Manuel3409/BauhallenUhr/Bilder/CABLE-PH04_sml.webp

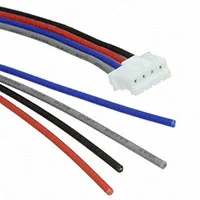
Bilder/CABLE-PH04_sml.webp
