Manuel3409/BauhallenUhr/README.md

# BauhallenUhr
Rework of the original BauhallenUhr - Projekt.
