Manuel3409/BauhallenUhr/Datenblaetter/Cable_Connector_XT60H_F.md

Cable\_Connector\_XT60H\_F

Link: [https://www.tme.eu/de/details/xt60h-f/dc-steckverbinder/amass/](https://www.tme.eu/de/details/xt60h-f/dc-steckverbinder/amass/)
