Manuel3409/BauhallenUhr/Datenblaetter/PCB_Connector_XT60PW_M.md

PCB\_Connector\_XT60PW\_M

Link: [https://www.tme.eu/de/details/xt60pw-m/dc-steckverbinder/amass/](https://www.tme.eu/de/details/xt60pw-m/dc-steckverbinder/amass/)
