Manuel3409/BauhallenUhr/00_Vorlagen_IPA/Vorlage_Bildformatierung.docx

Mit Textfeld:


Abbildung 1: ESP32S3 Devkit C1, Espressif

Abbildung 1: Unsichtbares Textfeld, darin befindet sich Bild und Bildbeschriftung.

Textfeld fixiert auf Seite, Textumbruch «oben und unten».

Abbildungsverzeichnis
