Manuel3409/BauhallenUhr/Bilder/300px-ST3025_Servo.jpg

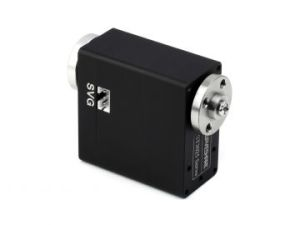
Bilder/300px-ST3025_Servo.jpg
