Manuel3409/BauhallenUhr/Blackbox_BauhallenUhr_V0.1.png

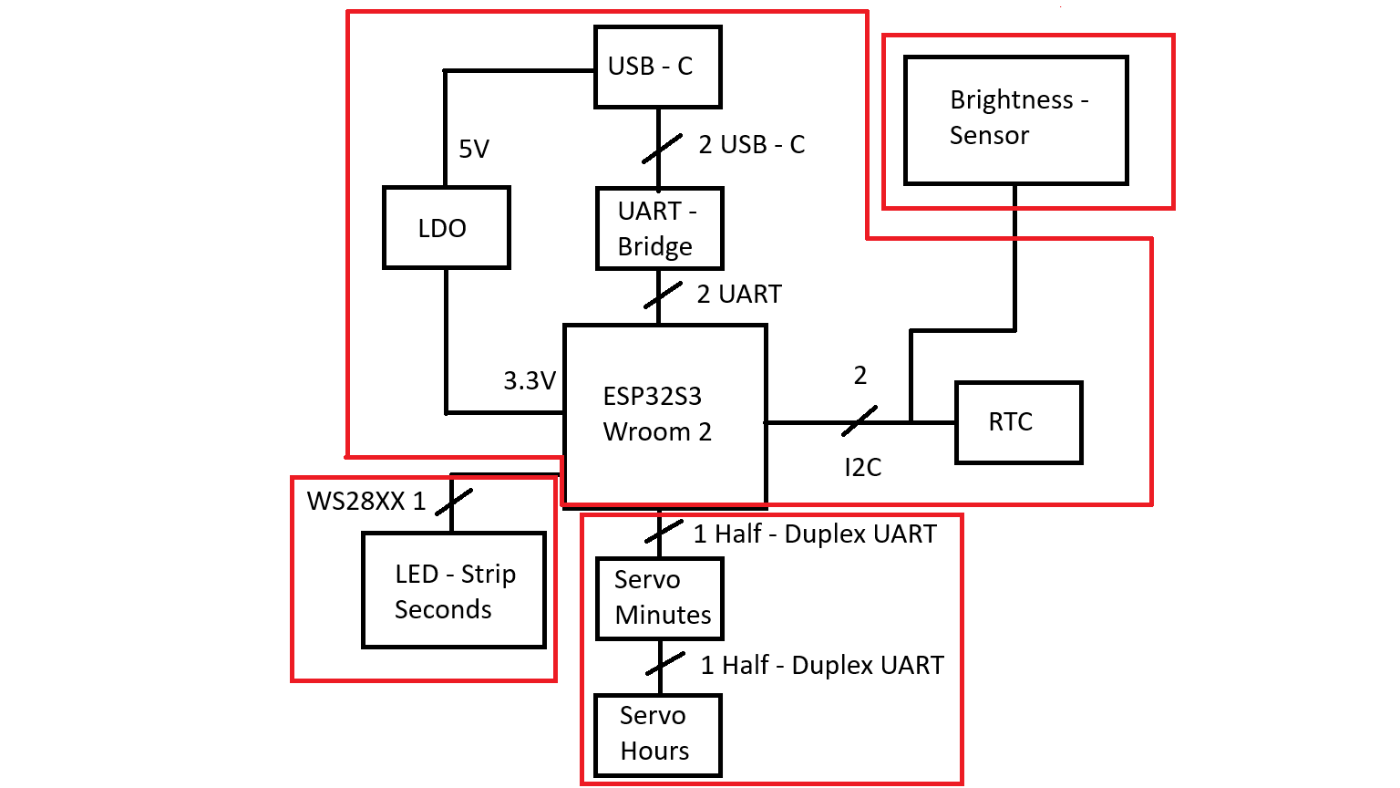
Blackbox_BauhallenUhr_V0.1.png
