Manuel3409/BauhallenUhr/00_Vorlagen_IPA/Stückliste_Vorlage.xlsx

Bestellliste IBK DBAUG
Anzahl PCBs |  | 1
 | Bezeichnung | Name | Wert | Anzahl pro Print | Anzahl gesamt | Zu bestellen | Stückpreis | Preis gesamt | Lieferant | Artikelnummer | Herstellernummer | Bestellstatus
1 |  |  |  |  | 0 |  |  | CHF 0.00
2 |  |  |  |  | 0 |  |  | CHF 0.00
3 |  |  |  |  | 0 |  |  | CHF 0.00
4 |  |  |  |  | 0 |  |  | CHF 0.00
 |  |  |  |  |  |  | Gesamtpreis | CHF 0.00
 | Nicht gefunden
 | Bestellt
 | Nicht bestellt
