Manuel3409/BauhallenUhr/Altium_BauhallenUhr_V2.0/3D_Modelle/SK68XXMINI-HS--3DModel-STEP-269445.STEP

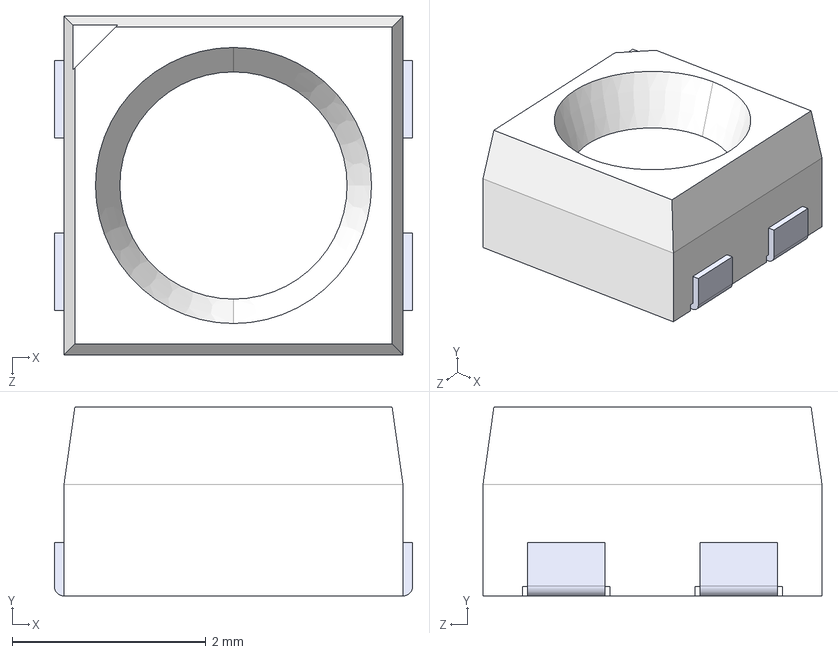
[picture p64: CAD file, 2026-10-23]
Altium_BauhallenUhr_V2.0/3D_Modelle/SK68XXMINI-HS--3DModel-STEP-269445.STEP
3.70 x 1.95 x 3.50 mm
