Manuel3409/BauhallenUhr/Altium_BauhallenUhr_V2.0/BauhallenUhr.pdf

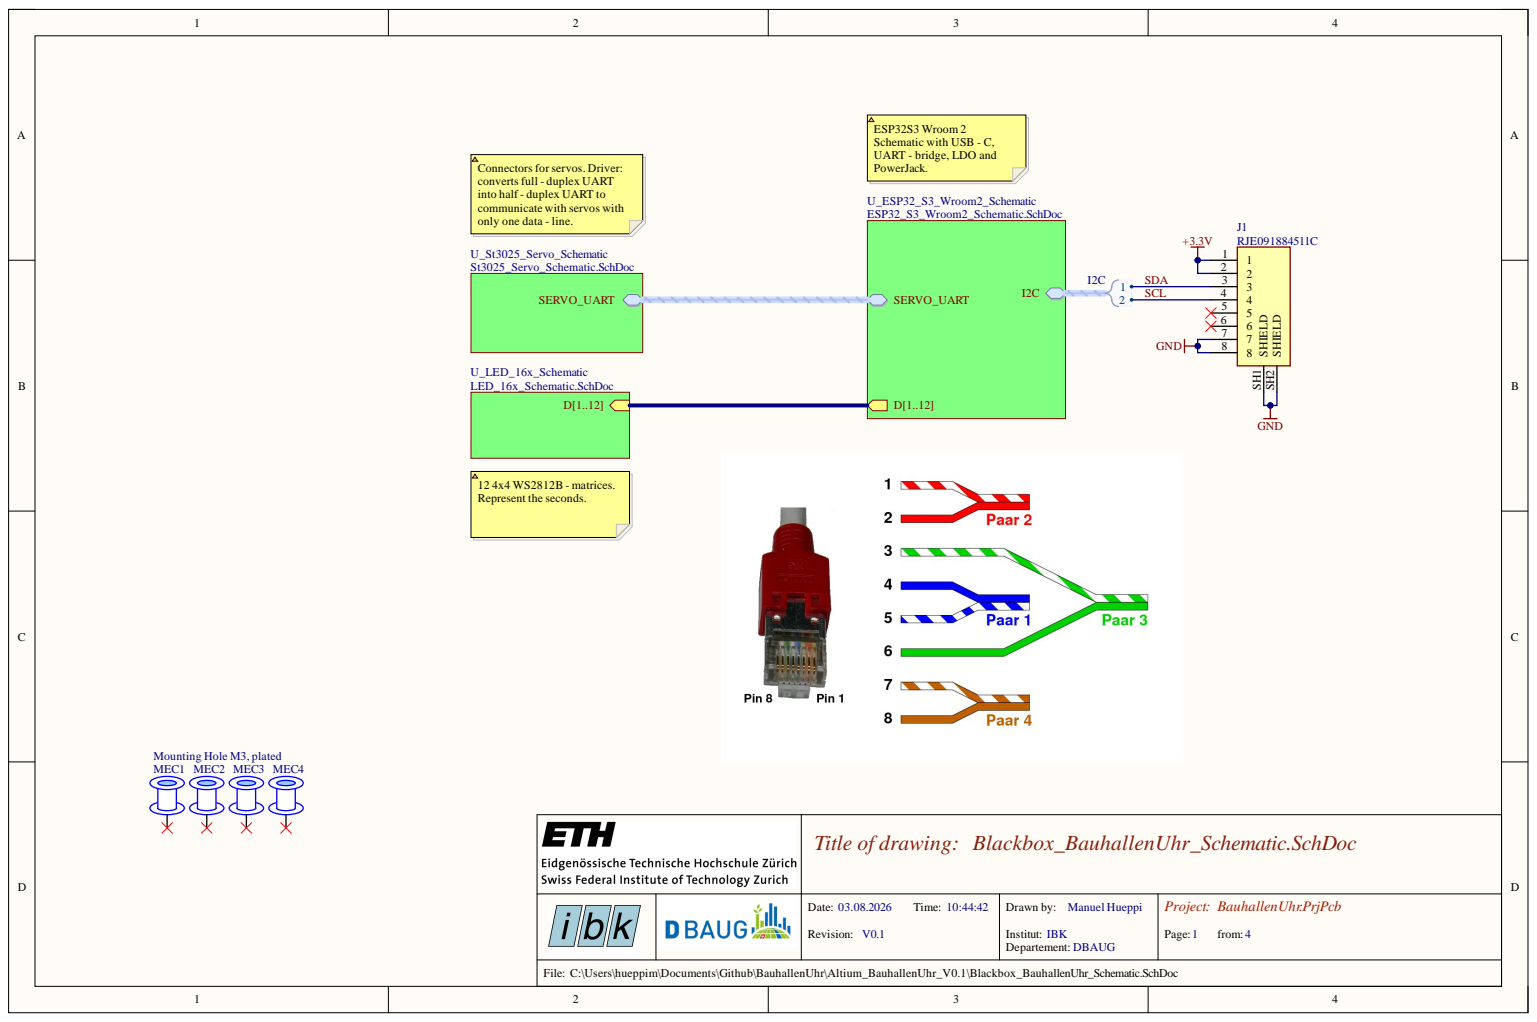
[picture p65: page 1]

Title of drawin g : Blackb ox_Ba u h allenUhr_ S c h e m a t i c . S c h D o c

Dat e : 0 3.0 8 . 2 0 2 6 T ime : 1 0 : 4 4 : 4 2 Rev i s i o n : V 0 . 1 | Draw n b y : Man uel H uep p i In s t i tu t : IBK Departemen t : DBA U G | Proje c t: Ba u h alle nUh r. P rjP c b Pag e : 1 fro m : 4

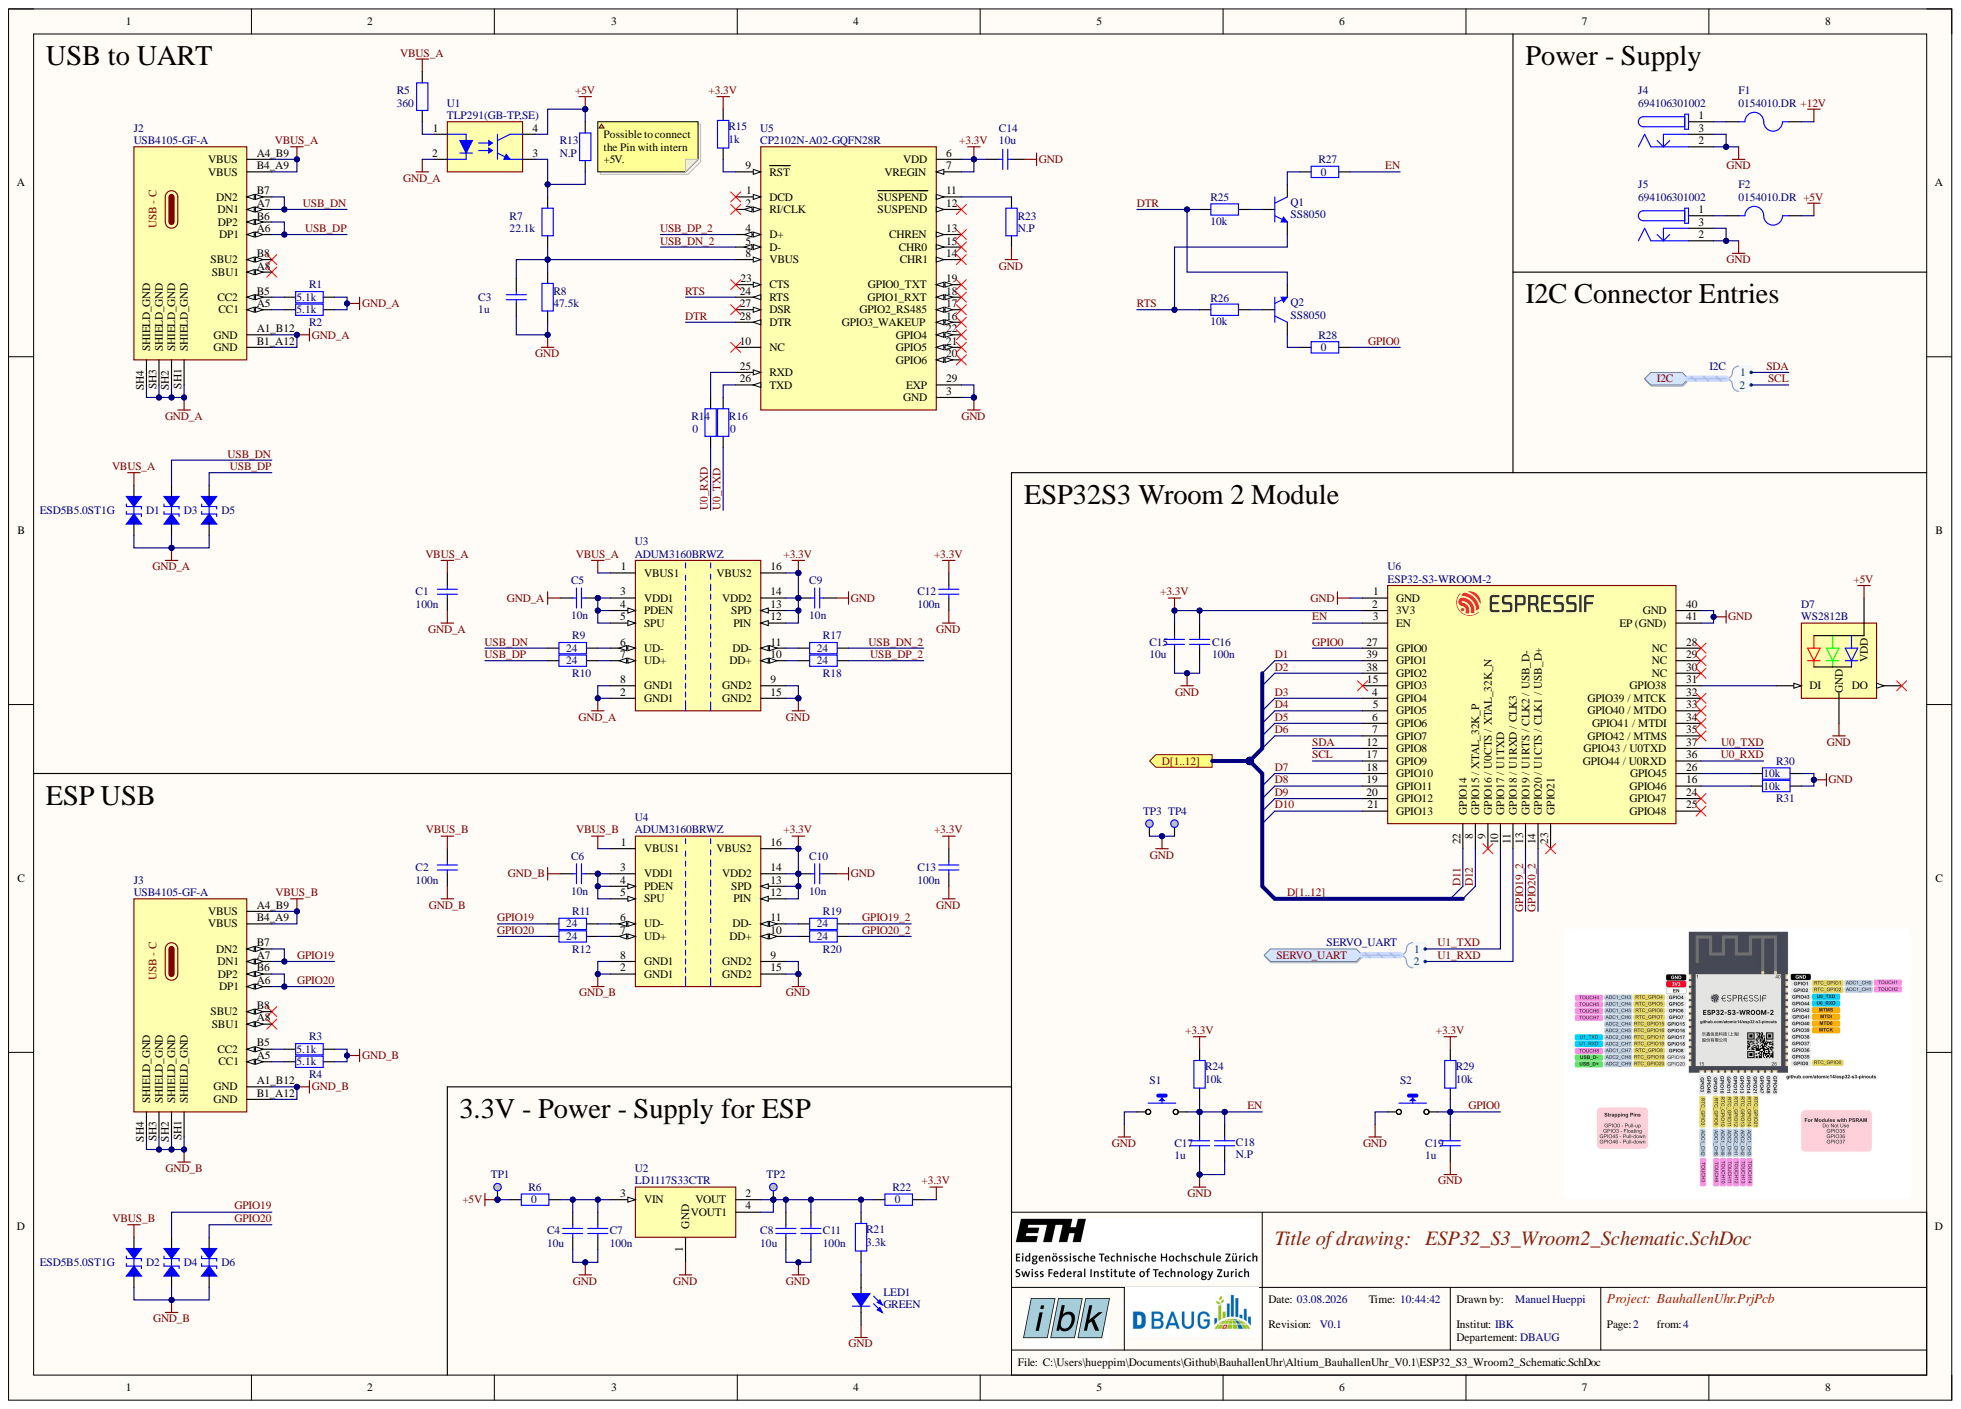
[picture p66: page 2]

Title of drawing: Date: Revision:

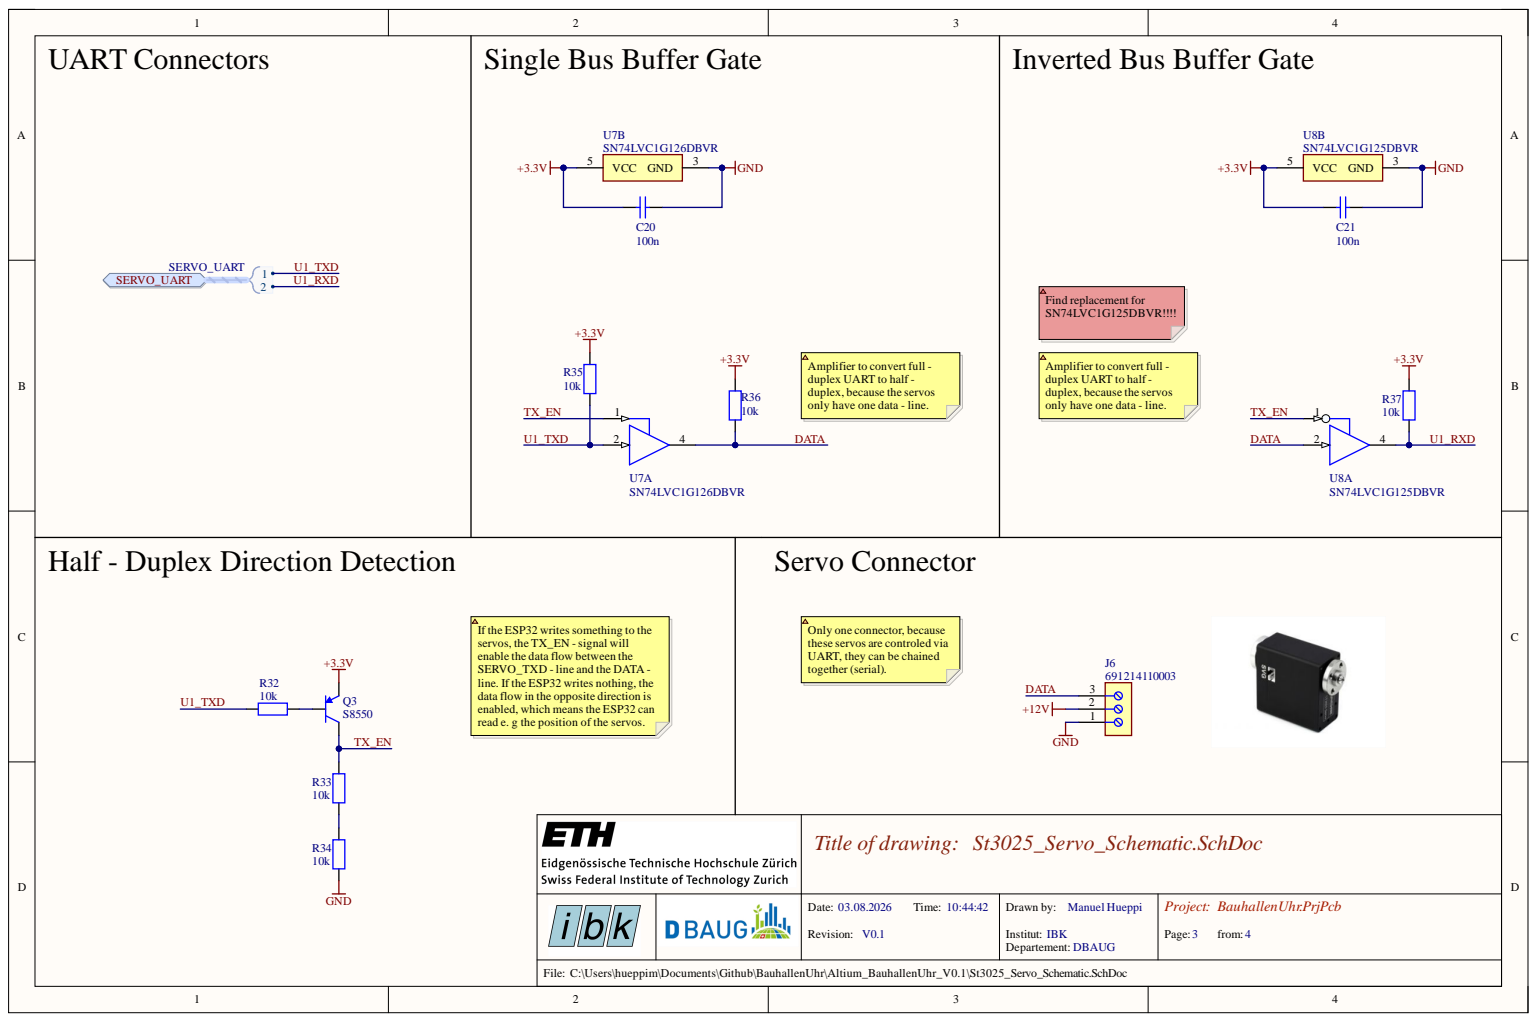
[picture p67: page 3]

Amplifier to convert full -
duplex UART to half -
duplex, because the servos
only have one data - line.

If the ESP32 writes something to the
servos, the TX_EN - signal will
enable the data flow between the
SERVO_TXD - line and the DATA -
line. If the ESP32 writes nothing, the
data flow in the opposite direction is
enabled, which means the ESP32 can
read e. g the position of the servos.

Only one connector, because
these servos are controled via
UART, they can be chained
together (serial).

Title of drawing: St3025_Servo_Schematic.SchDoc

Date: 03.08.2026 Time: 10:44:42 Revision: V0.1 | Drawn by: Manuel Hueppi Institut: IBK Departement: DBAUG | Project: BauhallenUhr.PrjPcb Page: 3 from: 4

C:\Users\hueppim\Documents\Github\BauhallenUhr\Altium_BauhallenUhr_V0.1\St3025_Servo_Schematic.SchDoc

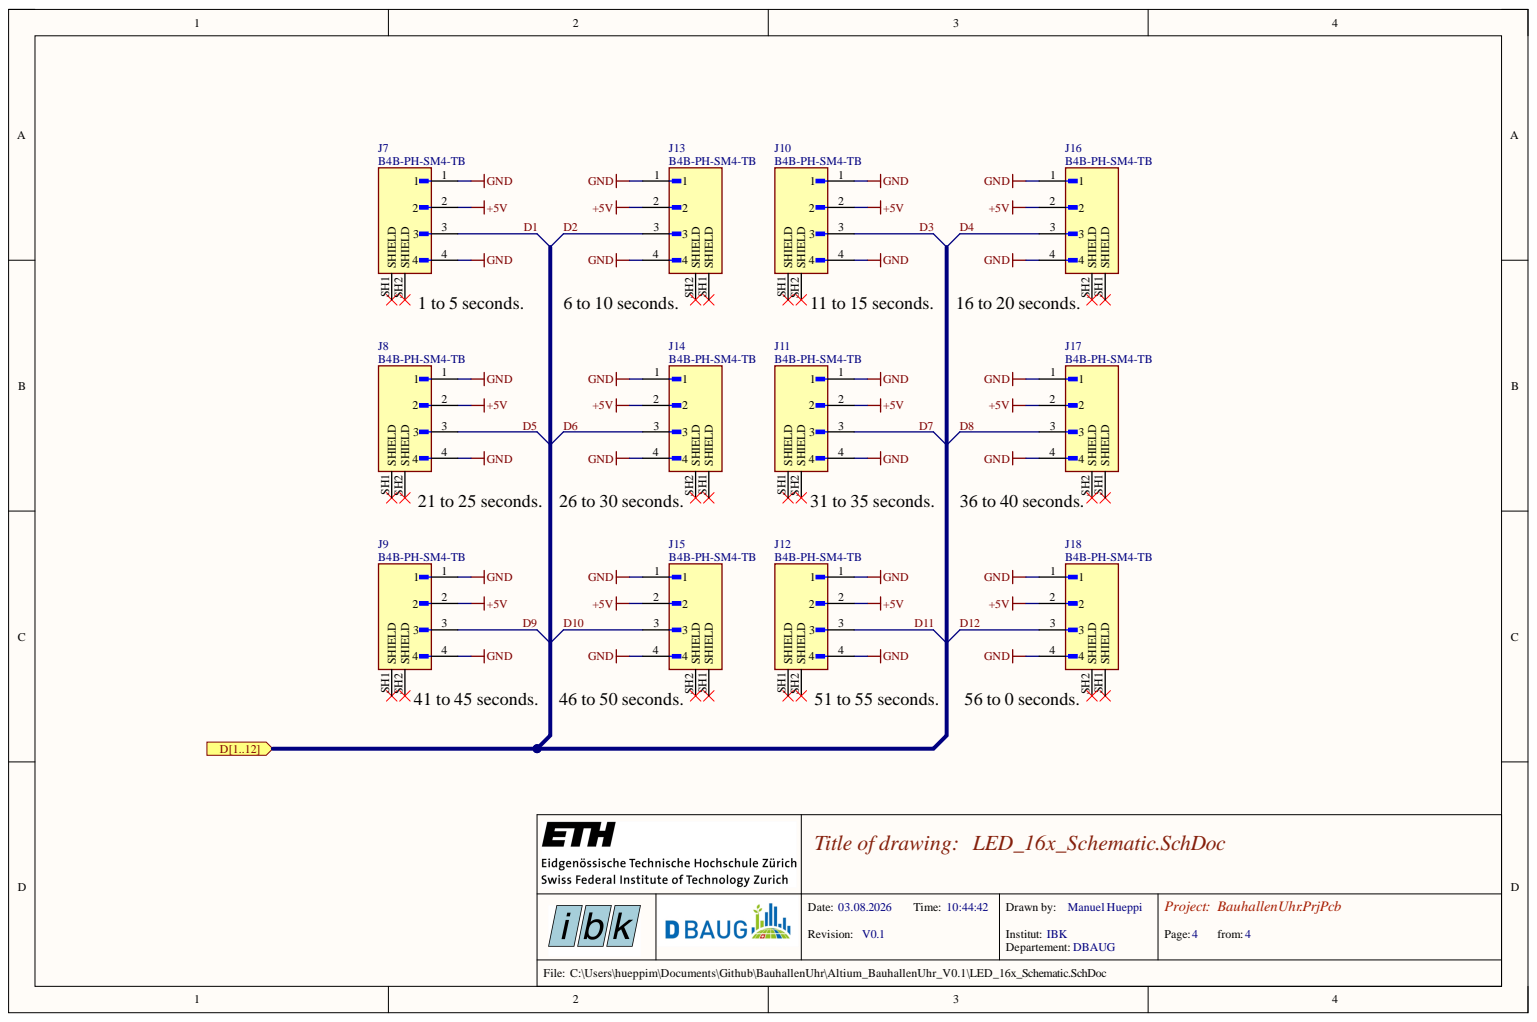
[picture p68: page 4]

21 to 25 seconds. 26 to 30 seconds.

Title of drawing: LED_16x_Schematic.SchDoc

Date: 03.08.2026 Time: 10:44:42 Revision: V0.1 | Drawn by: Manuel Hueppi Institut: IBK Departement: DBAUG | Project: BauhallenUhr.PrjPcb Page: 4 from: 4

C:\Users\hueppim\Documents\Github\BauhallenUhr\Altium_BauhallenUhr_V0.1\LED_16x_Schematic.SchDoc
