Manuel3409/BauhallenUhr/(list of files, drawings)

Other design files:
00_Vorlagen_IPA/IBK_Altium_Template_2_Layers/aaa_Empty_PCB_2_Layers.PcbDoc
00_Vorlagen_IPA/IBK_Altium_Template_2_Layers/aaa_Empty_Project_Template_2_Layers.PrjPcb
00_Vorlagen_IPA/IBK_Altium_Template_2_Layers/Empty_Main_Schematic.SchDoc
00_Vorlagen_IPA/IBK_DBAUG_Altium_Template_4_Layers/aaa_Empty_Project_Template_4_Layers.PrjPcb
00_Vorlagen_IPA/IBK_DBAUG_Altium_Template_4_Layers/Empty_Blackbox.SchDoc
00_Vorlagen_IPA/IBK_DBAUG_Altium_Template_4_Layers/Librarys/PCB_Altium_Library_Manuel.PcbLib
Altium_BauhallenUhr_V2.0/BauhallenUhr_V2.0.PcbDoc
Altium_BauhallenUhr_V2.0/BauhallenUhr_Variante_3.PcbDoc
Altium_BauhallenUhr_V2.0/BauhallenUhr_Variante_4.PcbDoc
Altium_BauhallenUhr_V2.0/ESP32_S3_Wroom2_Schematic.SchDoc
Altium_BauhallenUhr_V2.0/Librarys/0154010_DR/0154010.DR/0154010.DR.SchLib
Altium_BauhallenUhr_V2.0/Librarys/B4B-XH-A(LF)(SN)/B4B-XH-A(LF)(SN).SchLib
Altium_BauhallenUhr_V2.0/Librarys/B4B_PH_SM4_TB/B4B-PH-SM4-TB/JST_B4B-PH-SM4-TB.PcbLib
Altium_BauhallenUhr_V2.0/Librarys/Diode/Diode.SchLib
Altium_BauhallenUhr_V2.0/Librarys/LD1117S33CTR/SOT223.PcbLib
Altium_BauhallenUhr_V2.0/Librarys/RJE091884511C/RJE091884511C/AMPHENOL_RJE091884511C.PcbLib
Altium_BauhallenUhr_V2.0/Librarys/RJE091884511C/RJE091884511C/RJE091884511C.SchLib
Altium_BauhallenUhr_V2.0/Librarys/SS8050-G/SS8050-G.SchLib
Altium_BauhallenUhr_V2.0/Librarys/SS8050-G/TRANS_SS8050-G.PcbLib
Altium_BauhallenUhr_V2.0/Librarys/TLP291_GB_TP_SE/TLP291_GB-TP_SE/SOIC127P700X220-4N.PcbLib
Altium_BauhallenUhr_V2.0/Librarys/WS2812B/Imported WS2812B.lia/WS2812B.SchLib
Altium_Brightness_Sensor_V1.0/Brightness_Sensor.PrjPcb
Altium_Brightness_Sensor_V1.0/Brightness_Sensor_Schematic.SchDoc
Altium_Templates/IBK_Altium_Template_2_Layers/Main_Schematic_aaa_Empty_PCB_2_Layers.SchDoc
Altium_Templates/IBK_DBAUG_Altium_Template_4_Layers/aaa_Empty_Project_Template_4_Layers.PrjPcb
Altium_Templates/SMS_IBK_Altium_Template_2_Layers/aaa_Empty_PCB_2_Layers.PcbDoc
Altium_Templates/SMS_IBK_Altium_Template_2_Layers/Blackbox_aaa_Empty_PCB_2_Layers.SchDoc
Altium_Templates/SMS_IBK_Altium_Template_4_Layers/Blackbox_aaa_Empty_PCB_4_Layers.SchDoc
Altium_Templates/SMS_IBK_Altium_Template_4_Layers/Main_Schematic_aaa_Empty_PCB_4_Layers.SchDoc
Altium_Templates/Template Empty Altium Project, 4 Layers/aaa_Empty_Mechanical_Parts.SchDoc
Schaltungen_Vorlagen/Imported Adafruit VEML7700 STEMMA QT.PrjPcb/Adafruit VEML7700 STEMMA QT.PrjPcb
