Manuel3409/BauhallenUhr/(commit log)

2026-07-28 Neuer branch aufgesetzt, welcher alle Files und einen Altium - Ordner beinhaltet.
    [0154010.DR.SchLib, 10129380-905001BLF.SchLib, 1N5819HW-7-F--3DModel-STEP-56544.STEP, 1N5819HW-7-F.SchLib, 694106301002.PcbLib, 694106301002.SchLib, ADUM3160BRWZ.PcbLib, ADUM3160BRWZ.SchLib]
2026-07-28 IPA - Vorlagen hinzugefügt.
    [0154010.DR.SchLib, 10129380-905001BLF.SchLib, 1N5819HW-7-F--3DModel-STEP-56544.STEP, 1N5819HW-7-F.SchLib, 694106301002.PcbLib, 694106301002.SchLib, ADUM3160BRWZ.PcbLib, ADUM3160BRWZ.SchLib]
2026-07-28 Relais Schema - Symbol und Footprint hochgeladen.
    [Bauhalle_Zeitplan_woechentlich.xlsx, G5CA_1A_E.step]
2026-07-28 Schema fertig.
    [Diode.PcbLib, Diode.SchLib, Power_Relay.PcbLib, Power_Relay.SchLib]
2026-07-29 Optokoppler - Ergänzung begonnen.
    [Bauhalle_Zeitplan_woechentlich.xlsx, SOIC127P700X220-4N.PcbLib, TLP291(GB-TP,SE.SchLib]
2026-07-30 Simulation Optokoppler.
    [Bauhalle_Zeitplan_woechentlich.xlsx]
2026-07-30 Kommentare bei Zeitplanung hinzugefügt.
    [Bauhalle_Zeitplan_woechentlich.xlsx]
2026-07-30 Zwischenstand gespeichtert um an anderem PC zu arbeiten.
    [AMPHENOL_RJE091884511C.PcbLib, Bauhalle_Zeitplan_woechentlich.xlsx, RJE091884511C.SchLib]
2026-07-31 Projekt unterteilt in zwei Projekte.
    [Blackbox_Brightness_Sensor_Schematic.SchDoc, Brightness_Sensor_Schematic.SchDoc, aaa_Empty_PCB_2_Layers.PcbDoc, aaa_Empty_Project_Template_2_Layers.PrjPcb]
2026-09-11 Aktuellster Stand.
    [AMASS_XT60PW-M.PcbLib, BGA133C127P12X12_1500X1500X512N.PcbLib, Bauhalle_Zeitplan_woechentlich.xlsx, BauhallenUhr_Variante_1.PcbDoc, BauhallenUhr_Variante_3.PcbDoc, LTM4627EY#PBF.STEP, LTM4627EY#PBF.SchLib, XT60PW-M--3DModel-STEP-740395.STEP]
2026-10-21 Brightness Sensor Version aktualisiert auf V1.0.
